mikenicholson/gaggia_controller_pcb/README.md

gaggia_controller_pcb
=====================

A basic PID controller based on the Atmega328p to control my espresso machine.
