mikenicholson/gaggia_controller_pcb/gaggia_controller_bom.xlsx

Description | Value | Name | Schematic | Qty | Supplier | Part No. | Unit Cost | Link
Atmega 8 |  | IC1 | gaggia_controller | 1 | Oh Hand
Vreg-5v | LM340s | IC2 | gaggia_controller | 1 | Digikey | LM340S-5.0/NOPB-ND | 1.66 | buy (http://www.digikey.com/product-detail/en/LM340S-5.0%2FNOPB/LM340S-5.0%2FNOPB-ND/44627) | Make Symbol/Package in Eagle
MAXX6675 |  | IC3 | gaggia_controller | 1 | Sparkfun | COM-00307 | 11.95 | buy (https://www.sparkfun.com/products/307)
CRYSTALHC49S | 16.0Mhz | Q1 | gaggia_controller | 1 | On Hand
Capacitor, PTH-Small | 0.1uF | C1,C4 | gaggia_controller | 2 | Sparkfun | PRT-8375 | 0.25 | buy (https://www.sparkfun.com/products/8375) | Power Supply, Not in Schematic
Capacitor, PTH-Small | 22pF | C2-C3 | gaggia_controller | 2 | Sparkfun | COM-08571 | 0.25 | buy (https://www.sparkfun.com/products/8571)
Capacitor, PTH-Small Ceramic Disk | 22uF | C5 | gaggia_controller |  | Digikey | 445-8475-ND | 1.71 | buy (http://www.digikey.com/product-detail/en/FK22X5R1E226M/445-8475-ND/2815405)
Capacitor | 100nF | C6 | gaggia_controller |  | Sparkfun | PRT-11245 | 0.03 | buy (https://www.sparkfun.com/products/11245?)
Resistor, SMD-1206 | 10kOhm, 1/4 Watt | R1,R4 | gaggia_controller | 1 | On Hand
Screw Terminal 5.0mm -2 |  | JP1, JP2,JP4, JP5 | gaggia_controller | 4 | Sparkfun | PRT-08432 | 0.95 | buy (https://www.sparkfun.com/products/8432)
Shrouded Header 2x5 |  | JP3 | gaggia_controller | 1 | Sparkfun | PRT-08506 | 1.5 | buy (https://www.sparkfun.com/products/8506)
ICSP Header | 6-PTH | J1 | gaggia_controller | 1 | On Hand
Resistor, SMD-1206 | 128 Ohm | R2, R3 | gaggia_controller | 2 | Digikey | P130FCT-ND | 0.1 | buy (http://www.digikey.com/product-detail/en/ERJ-8ENF1300V/P130FCT-ND/89325)
LED, SMD-0603 | Green | LED1 | gaggia_controller | 1 | Sparkfun | PRT-11249 | 0.2 | buy (https://www.sparkfun.com/products/11249)
LED, SMD-0603 | Red | LED2 | gaggia_controller | 1 | Sparkfun | PRT-11248 | 0.24 | buy (https://www.sparkfun.com/products/11248)
16x2 LCD |  | U1 | Interface_panel | 1
Ribbon Cable - 10 Conductor | 15ft |  | Connector Cable |  | Sparkfun | CAB-10647
Keyed Header, Femal |  |  | Connector Cable | 2 | Digikey
