mikenicholson/gaggia_controller_pcb/controller.brd

## EAGLE design controller.brd (2013-01-06)

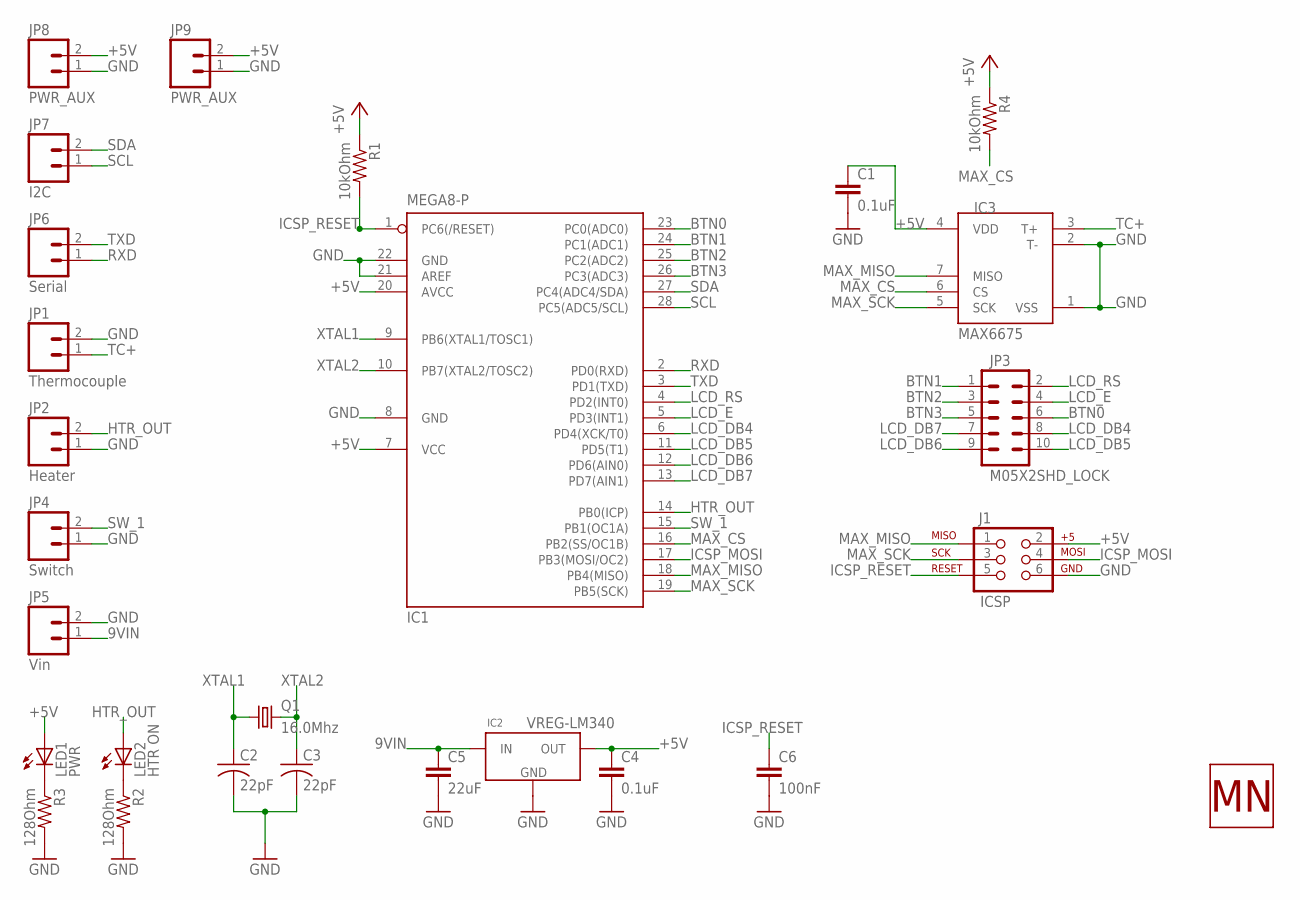
[picture p1: schematic controller.sch]

Parts:
C1, C4: 0.1uF; CAP-PTH-SMALL
C2, C3: 22pF; C025-030X050
C5: 22uF; CAP-PTH-5MM
C6: 100nF; 0603-CAP
IC1: MEGA8-P; DIL28-3
IC2: VREG-LM340; D2PACK/A
IC3: MAX6675; SO08-MAX6675
J1: ICSP; 2X3
JP1: Thermocouple; SCREWTERMINAL-5MM-2
JP2: Heater; SCREWTERMINAL-5MM-2
JP3: M05X2SHD_LOCK; 2X5-SHROUDED_LOCK
JP4: Switch; SCREWTERMINAL-5MM-2
JP5: Vin; SCREWTERMINAL-5MM-2
JP6: Serial; 1X02
JP7: I2C; 1X02
JP8: PWR_AUX; 1X02
JP9: PWR_AUX; MOLEX-1X2
LED1: PWR; LED-0603
LED2: HTR ON; LED-0603
Q1: 16.0Mhz; HC49/S
R1, R4: 10kOhm; 1206
R2, R3: 128Ohm; 1206
U$1: MN-LOGO

Connections:
9VIN: C5.1, IC2.1 (IN), JP5.1
+5V: C1.1, C4.1, IC1.7 (VCC), IC1.20 (AVCC), IC2.3 (OUT), IC3.4 (VDD), J1.2, JP8.2, JP9.2, LED1.A, R1.1, R4.1
BTN0: IC1.23 (PC0(ADC0)), JP3.6
BTN1: IC1.24 (PC1(ADC1)), JP3.1
BTN2: IC1.25 (PC2(ADC2)), JP3.3
BTN3: IC1.26 (PC3(ADC3)), JP3.5
GND: C1.2, C2.2, C3.2, C4.2, C5.2, C6.2, IC1.8 (GND), IC1.21 (AREF), IC1.22 (GND), IC2.2 (GND), IC2.TAB (GND), IC3.1 (VSS), IC3.2 (T-), J1.6, JP1.2, JP2.1, JP4.1, JP5.2, JP8.1, JP9.1, R2.2, R3.2
HTR_OUT: IC1.14 (PB0(ICP)), JP2.2, LED2.A
ICSP_MOSI: IC1.17 (PB3(MOSI/OC2)), J1.4
ICSP_RESET: C6.1, IC1.1 (PC6(/RESET)), J1.5, R1.2
LCD_DB4: IC1.6 (PD4(XCK/T0)), JP3.8
LCD_DB5: IC1.11 (PD5(T1)), JP3.10
LCD_DB6: IC1.12 (PD6(AIN0)), JP3.9
LCD_DB7: IC1.13 (PD7(AIN1)), JP3.7
LCD_E: IC1.5 (PD3(INT1)), JP3.4
LCD_RS: IC1.4 (PD2(INT0)), JP3.2
MAX_CS: IC1.16 (PB2(SS/OC1B)), IC3.6 (CS), R4.2
MAX_MISO: IC1.18 (PB4(MISO)), IC3.7 (MISO), J1.1
MAX_SCK: IC1.19 (PB5(SCK)), IC3.5 (SCK), J1.3
unnamed: LED1.C, R3.1
unnamed: LED2.C, R2.1
RXD: IC1.2 (PD0(RXD)), JP6.1
SCL: IC1.28 (PC5(ADC5/SCL)), JP7.1
SDA: IC1.27 (PC4(ADC4/SDA)), JP7.2
SW_1: IC1.15 (PB1(OC1A)), JP4.2
TC+: IC3.3 (T+), JP1.1
TXD: IC1.3 (PD1(TXD)), JP6.2
XTAL1: C2.1, IC1.9 (PB6(XTAL1/TOSC1)), Q1.1
XTAL2: C3.1, IC1.10 (PB7(XTAL2/TOSC2)), Q1.2

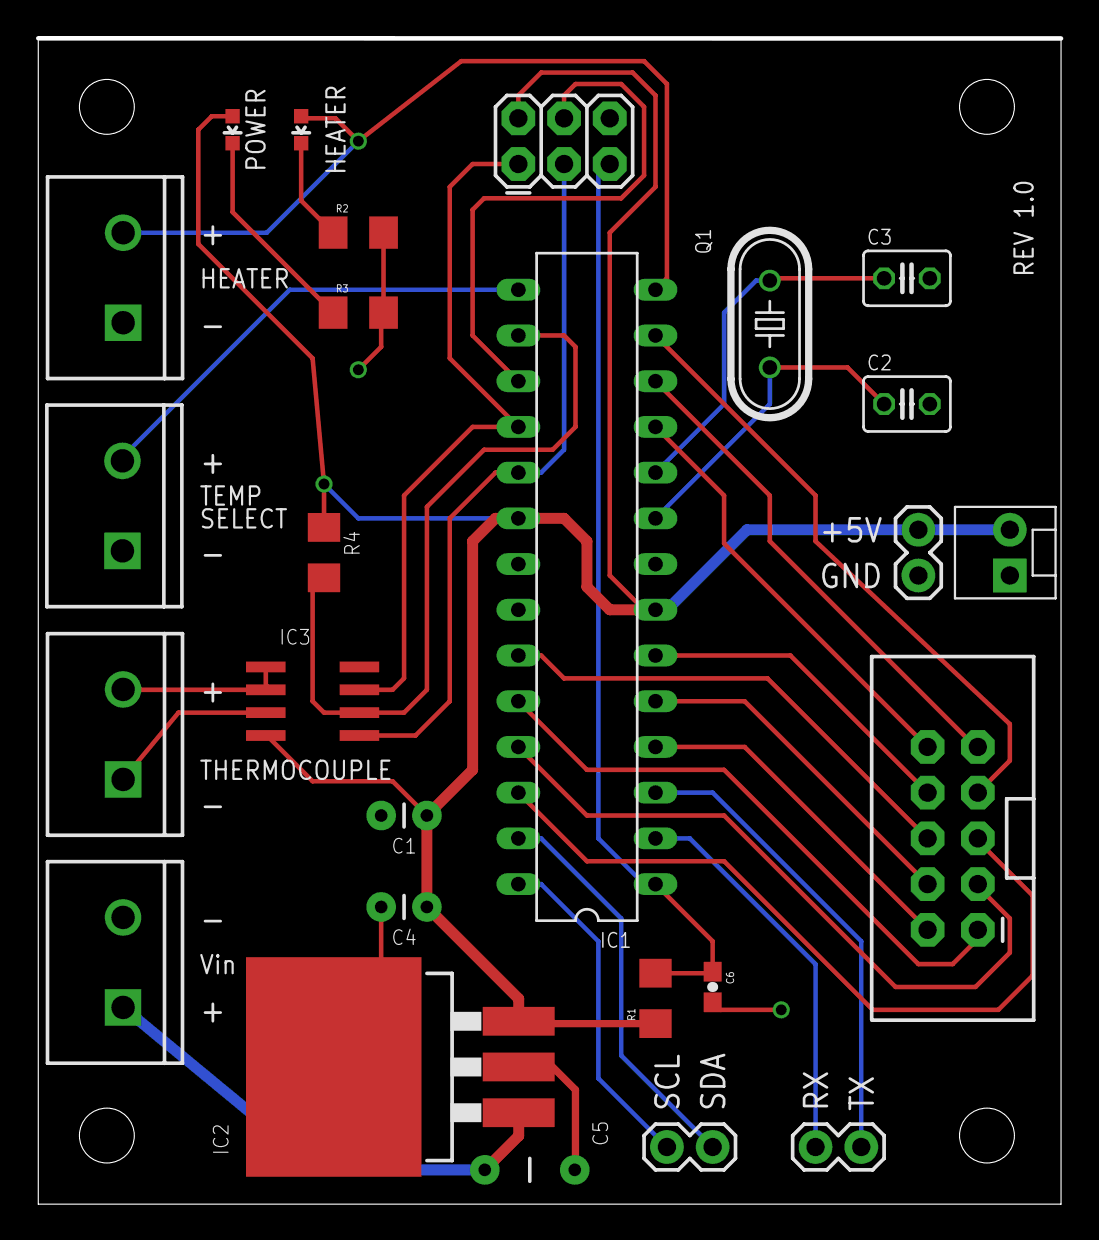
[picture p2: board controller.brd from above]

Board: 2 copper layers, 56.8 x 64.8 mm, 31 parts (1 on the bottom side), 29 nets.

Other parts of the board:
U$2, U$3, U$4, U$5: STAND-OFF-TIGHT
