mikenicholson/gaggia_controller_pcb/interface.brd

## EAGLE design interface.brd (2013-01-06)

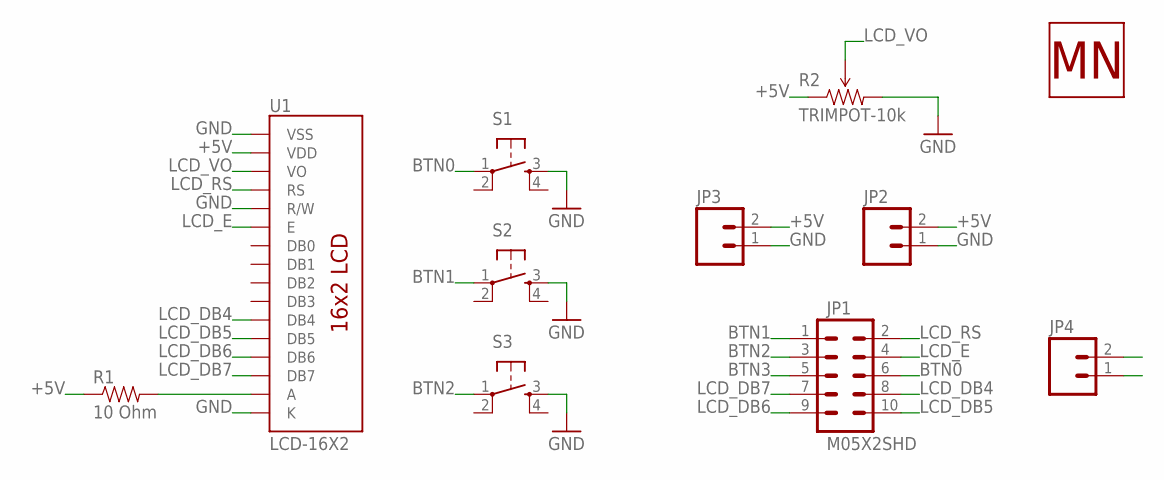
[picture p3: schematic interface.sch]

Parts:
JP1: M05X2SHD; 2X5-SHROUDED
JP2: M02POLAR; MOLEX-1X2
JP3, JP4: M02PTH; 1X02
R1: 10 Ohm; 1206
R2: TRIMPOT-10k; TRIMPOT_TC33
S1, S2, S3: TAC_SWITCHPTH; TACTILE-PTH
U1: LCD-16X2; LCD-16X2_NOLEFTDRILL
U$5: MN-LOGO

Connections:
+5V: JP2.2, JP3.2, R1.1, R2.1 (CCW), U1.2 (VDD)
BTN0: JP1.6, S1.1
BTN1: JP1.1, S2.1
BTN2: JP1.3, S3.1
BTN3: JP1.5, JP4.2
GND: JP2.1, JP3.1, JP4.1, R2.3 (CW), S1.3, S2.3, S3.3, U1.1 (VSS), U1.5 (R/W), U1.16 (K)
LCD_DB4: JP1.8, U1.11 (DB4)
LCD_DB5: JP1.10, U1.12 (DB5)
LCD_DB6: JP1.9, U1.13 (DB6)
LCD_DB7: JP1.7, U1.14 (DB7)
LCD_E: JP1.4, U1.6 (E)
LCD_RS: JP1.2, U1.4 (RS)
LCD_VO: R2.2 (WIPER), U1.3 (VO)
unnamed: R1.2, U1.15 (A)

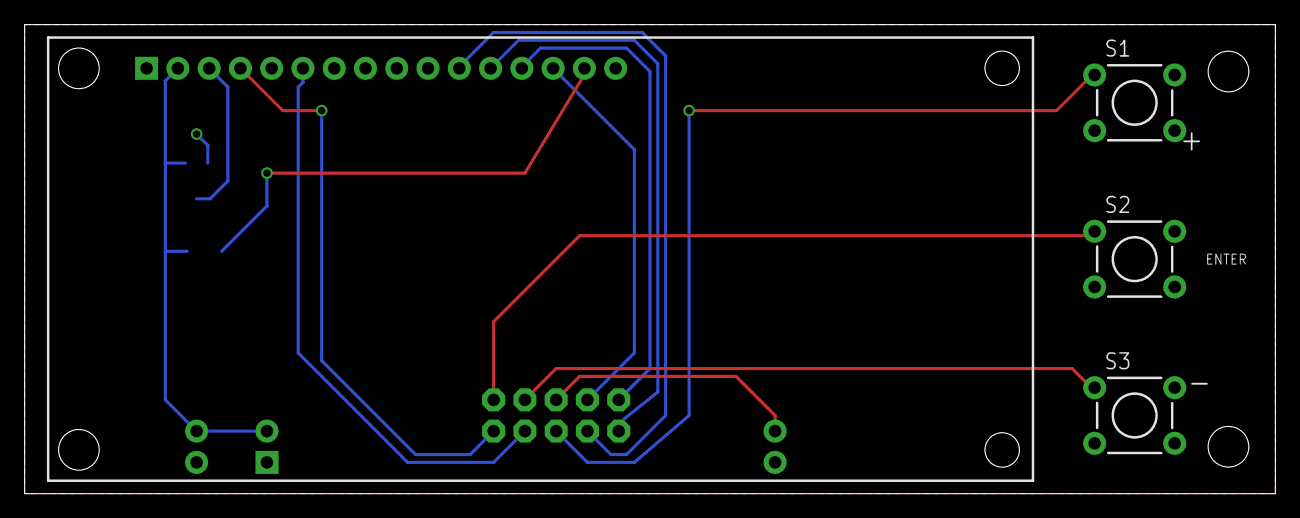
[picture p4: board interface.brd from above]

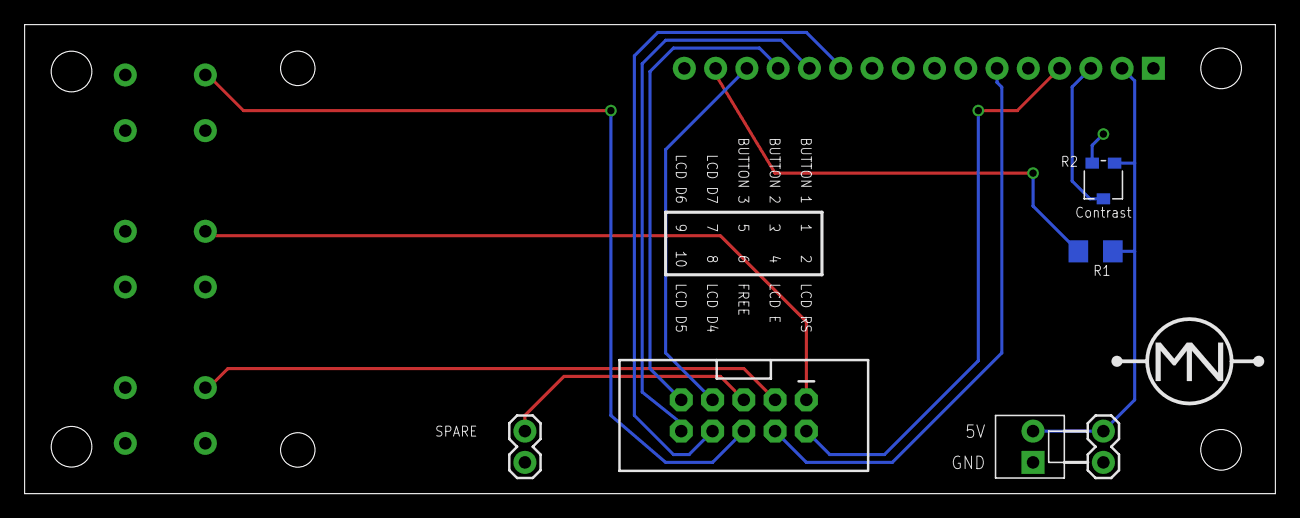
[picture p5: board interface.brd from below]

Board: 2 copper layers, 101.6 x 38.1 mm, 15 parts (7 on the bottom side), 14 nets.

Other parts of the board:
U$1, U$2, U$3, U$4: STAND-OFF
