mikenicholson/gaggia_controller_pcb/(commit log)

2012-12-09 Initial checkin of all files.
    [board.brd, board.sch, gaggia_controller_bom.xlsx]
2012-12-09 Adding git ignore. Don't track automatically create backups
2012-12-09 Renamed files to allow for creating interface board.
    [controller.brd, controller.sch]
2012-12-10 Added schematic and layout for interface file.
    [interface.brd, interface.sch]
2012-12-10 Removed extraneous silkscreen
    [interface.brd]
2012-12-11 Added silk screen documentation for 10 pin connector
    [interface.brd]
2012-12-11 Cleaning up DRC issues
    Sparkfun package TRIMPOT_TC33 had issues with silkscreen. SS from LCD was passing over some pads. Switched LCD ss to tDocu and cleaned up ss lines on trimpot so they no longer overlapped the pads.
    [interface.brd, interface.sch]
2012-12-11 Added header for spare pin from 10pin connector.
    Added a 2pin header to allow access to the "spare" pin on the 10 pin
    header.
    [interface.brd, interface.sch]
2012-12-12 Fixed orientation of screw terminals.
    Screw terminals were oriented with receptacle facing inwards towards
    the center of the board. Rotated them and performed some pin swaps.
    Also added silk to label contrast trim pot on interface board.
    [controller.brd, controller.sch, interface.brd]
2012-12-13 Changed 1 of the aux power connectors to molex polarized header.
    Made change for interface and for controller boards
    [controller.brd, controller.sch, interface.brd, interface.sch]
2012-12-30 Silkscreen cleanup and terminal moves.
    Silkscreen was overlapping the pad for Heater LED's
    current limiting resitor. Also spaced out screw terminals.
    Prevents them from meshing but allows for use of different near
    -equivalent parts.
    [controller.brd]
2013-01-06 Updated some layout, added logo
    [controller.brd, controller.sch, interface.brd, interface.sch]
